heolfief/WakeupLightController/Software/Bluetooth data frame.pdf

1rst Byte | 2nd Byte
MSB | | | LSB | MSB | LSB
ID | | DAY | | DATA

# Bluetooth data frame
