heolfief/WakeupLightController/Hardware/Schematics.pdf

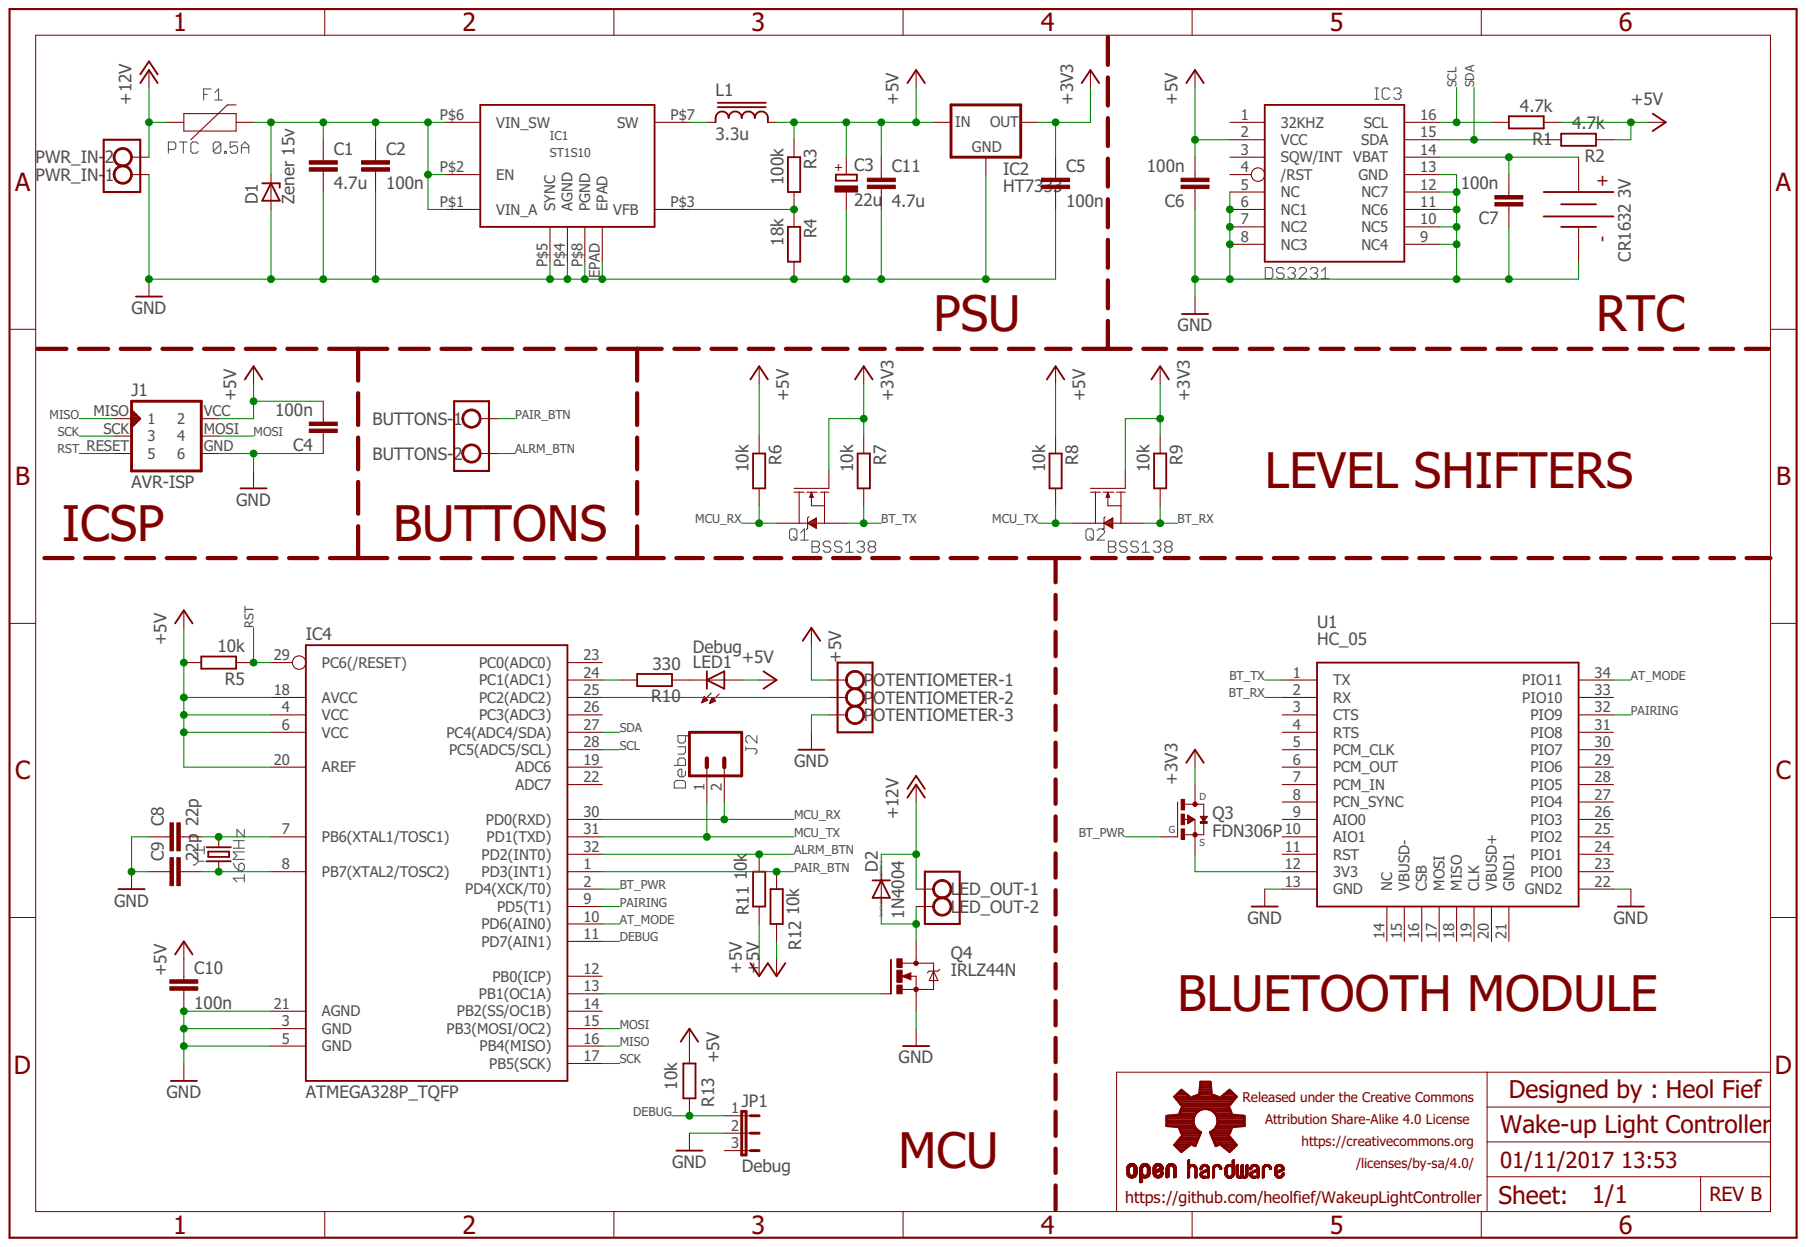
[picture p1: page 1]

Attribution Share-Alike 4.0 License https://creativecommons.org

https://github.com/heolfief/WakeupLightController
