heolfief/WakeupLightController/Software/States flowchart.pdf

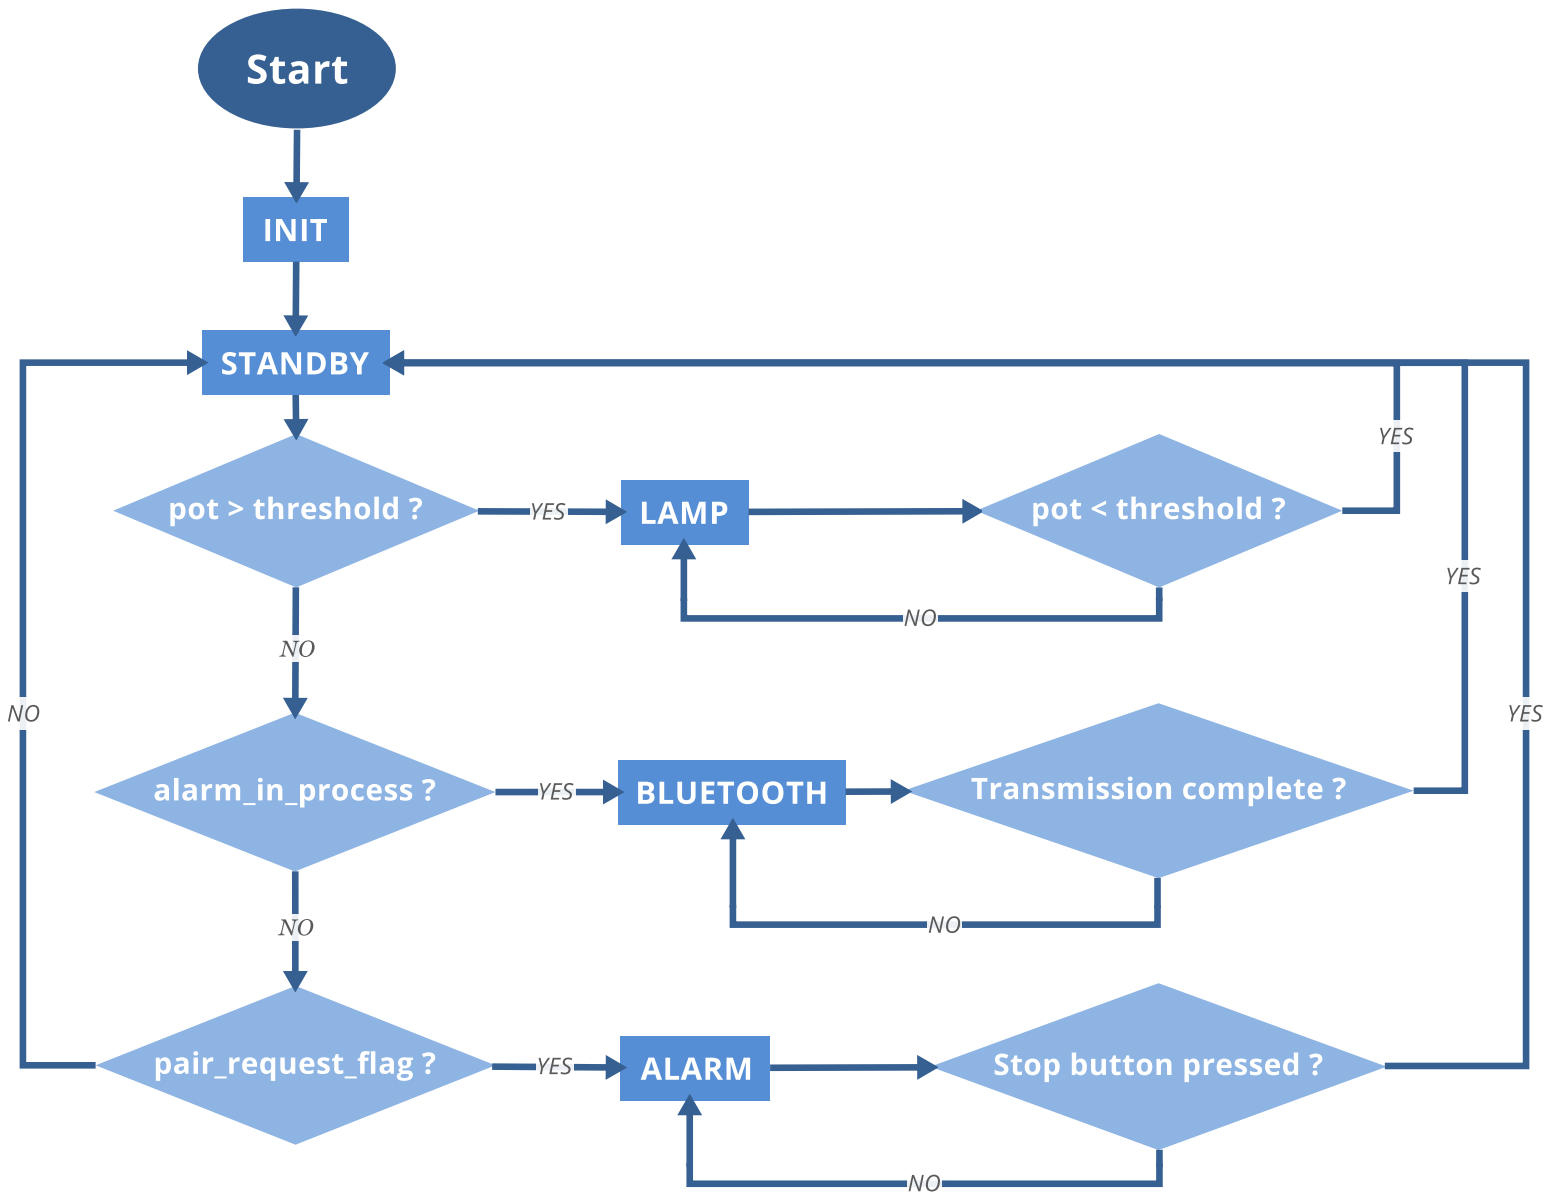
[picture p2: page 1]
