heolfief/WakeupLightController/Hardware/Wake-up Light Controller.brd

## EAGLE design Hardware/Wake-up Light Controller.brd (2017-11-01)

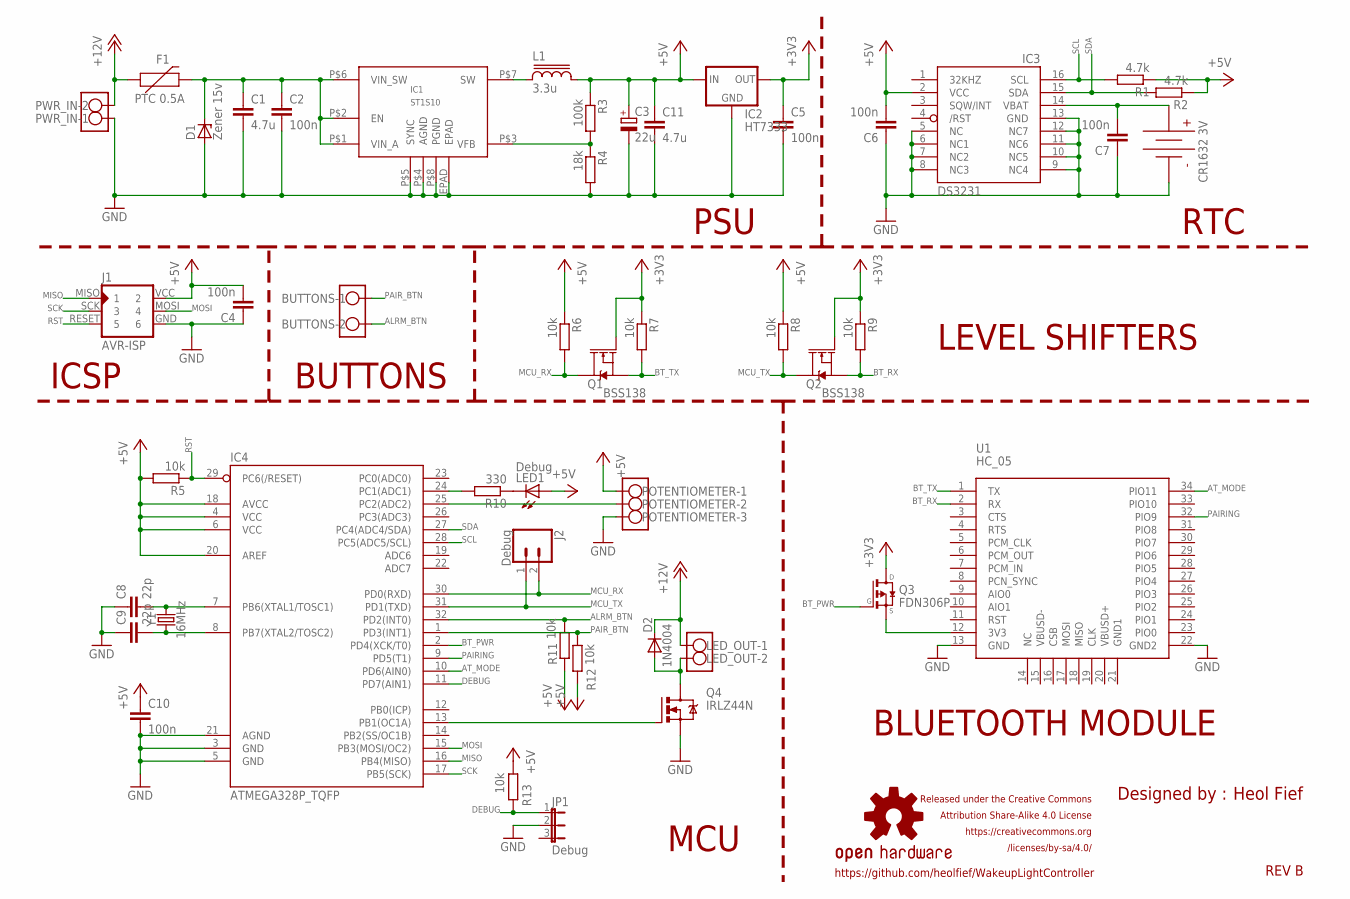
[picture p3: schematic Wake-up Light Controller.sch]

Parts:
BUTTONS: W237-102
C1, C11: 4.7u; C0805
C2, C4, C5, C6, C7, C10: 100n; C0805
C3: 22u; 153CLV-0405
C8, C9: 22p; C0805
D1: Zener 15v; SOD80C
D2: 1N4004; DO-214AC
F1: PTC 0.5A; PTH
IC1: ST1S10
IC2: HT7333; SOT-89
IC3: DS3231/SO; SO16W
IC4: ATMEGA328P_TQFP; TQFP32-08
J1: AVR-ISP; AVR-ISP-6PIN-SMAILL-SILK
J2: Debug; 1X02_NO_SILK
J3: CR1632_3V; BATTCON_16MM_PTH
JP1: Debug; JP2
L1: 3.3u; 74437346068
LED1: Debug; CHIPLED_1206
LED_OUT: W237-102
LOGO1: OSHW-LOGOM-COPPER; OSHW-LOGO-M_COPPER
POTENTIOMETER: W237-103
PWR_IN: W237-102
Q1, Q2: BSS138; SOT23-3
Q3: FDN306P; SSOT-3
Q4: IRLZ44N; TO220BH
R1, R2: 4.7k; M0805
R3: 100k; M0805
R4: 18k; M0805
R5, R6, R7, R8, R9, R11, R12, R13: 10k; M0805
R10: 330; M0805
U1: HC_05; BLUETOOTH_SMD
Y1: 16MHz; CRYSTAL-SMD-3.2X2.5MM

Connections:
+3V3: C5.1, IC2.1 (OUT), Q1.1 (G), Q2.1 (G), Q3.3 (D), R7.1, R9.1
+5V: C3.+, C4.2, C6.2, C10.1, C11.1, IC2.3 (IN), IC2.4 (IN), IC3.2 (VCC), IC4.4 (VCC), IC4.6 (VCC), IC4.18 (AVCC), IC4.20 (AREF), J1.VCC (2), L1.2, LED1.A, POTENTIOMETER.1, R1.1, R2.1, R3.1, R5.2, R6.1, R8.1, R11.1, R12.1, R13.2
+12V: D2.C, F1.P$1 (1), LED_OUT.1, PWR_IN.2
ALRM_BTN: BUTTONS.2, IC4.32 (PD2(INT0)), R11.2
AT_MODE: IC4.10 (PD6(AIN0)), U1.34 (PIO11)
BT_PWR: IC4.2 (PD4(XCK/T0)), Q3.1 (G)
BT_RX: Q2.2 (S), R9.2, U1.2 (RX)
BT_TX: Q1.2 (S), R7.2, U1.1 (TX)
DEBUG: IC4.11 (PD7(AIN1)), JP1.1, R13.1
GND: C1.2, C2.2, C3.-, C4.1, C5.2, C6.1, C7.1, C8.1, C9.1, C10.2, C11.2, D1.A, IC1.EPAD, IC1.P$4 (AGND), IC1.P$5 (SYNC), IC1.P$8 (PGND), IC2.2 (GND), IC3.5 (NC), IC3.6 (NC1), IC3.7 (NC2), IC3.8 (NC3), IC3.9 (NC4), IC3.10 (NC5), IC3.11 (NC6), IC3.12 (NC7), IC3.13 (GND), IC4.3 (GND), IC4.5 (GND), IC4.21 (AGND), J1.GND (6), J3.GND, JP1.2, POTENTIOMETER.3, PWR_IN.1, Q4.S, R4.2, U1.13 (GND), U1.22 (GND2)
MCU_RX: IC4.30 (PD0(RXD)), J2.2, Q1.3 (D), R6.2
MCU_TX: IC4.31 (PD1(TXD)), J2.1, Q2.3 (D), R8.2
MISO: IC4.16 (PB4(MISO)), J1.MISO (1)
MOSI: IC4.15 (PB3(MOSI/OC2)), J1.MOSI (4)
unnamed: D2.A, LED_OUT.2, Q4.D
unnamed: C8.2, IC4.7 (PB6(XTAL1/TOSC1)), Y1.3 (2)
unnamed: IC4.24 (PC1(ADC1)), R10.2
unnamed: C9.2, IC4.8 (PB7(XTAL2/TOSC2)), Y1.1
unnamed: Q3.2 (S), U1.12 (3V3)
unnamed: IC1.P$7 (SW), L1.1
unnamed: IC1.P$3 (VFB), R3.2, R4.1
unnamed: LED1.C, R10.1
unnamed: C1.1, C2.1, D1.C, F1.P$2 (2), IC1.P$1 (VIN_A), IC1.P$2 (EN), IC1.P$6 (VIN_SW)
unnamed: IC4.13 (PB1(OC1A)), Q4.G
unnamed: IC4.25 (PC2(ADC2)), POTENTIOMETER.2
PAIRING: IC4.9 (PD5(T1)), U1.32 (PIO9)
PAIR_BTN: BUTTONS.1, IC4.1 (PD3(INT1)), R12.2
RST: IC4.29 (PC6(/RESET)), J1.RESET (5), R5.1
SCK: IC4.17 (PB5(SCK)), J1.SCK (3)
SCL: IC3.16 (SCL), IC4.28 (PC5(ADC5/SCL)), R1.2
SDA: IC3.15 (SDA), IC4.27 (PC4(ADC4/SDA)), R2.2
VBAT: C7.2, IC3.14 (VBAT), J3.VCC@1 (VCC), J3.VCC@2 (VCC)

Notes on the sheet:
PSU
ICSP
MCU
REV B
Heol Fief
Designed by :
Released under the Creative Commons Attribution Share-Alike 4.0 License https://creativecommons.org /licenses/by-sa/4.0/
BLUETOOTH MODULE
RTC
BUTTONS
LEVEL SHIFTERS
CR1632 3V
https://github.com/heolfief/WakeupLightController

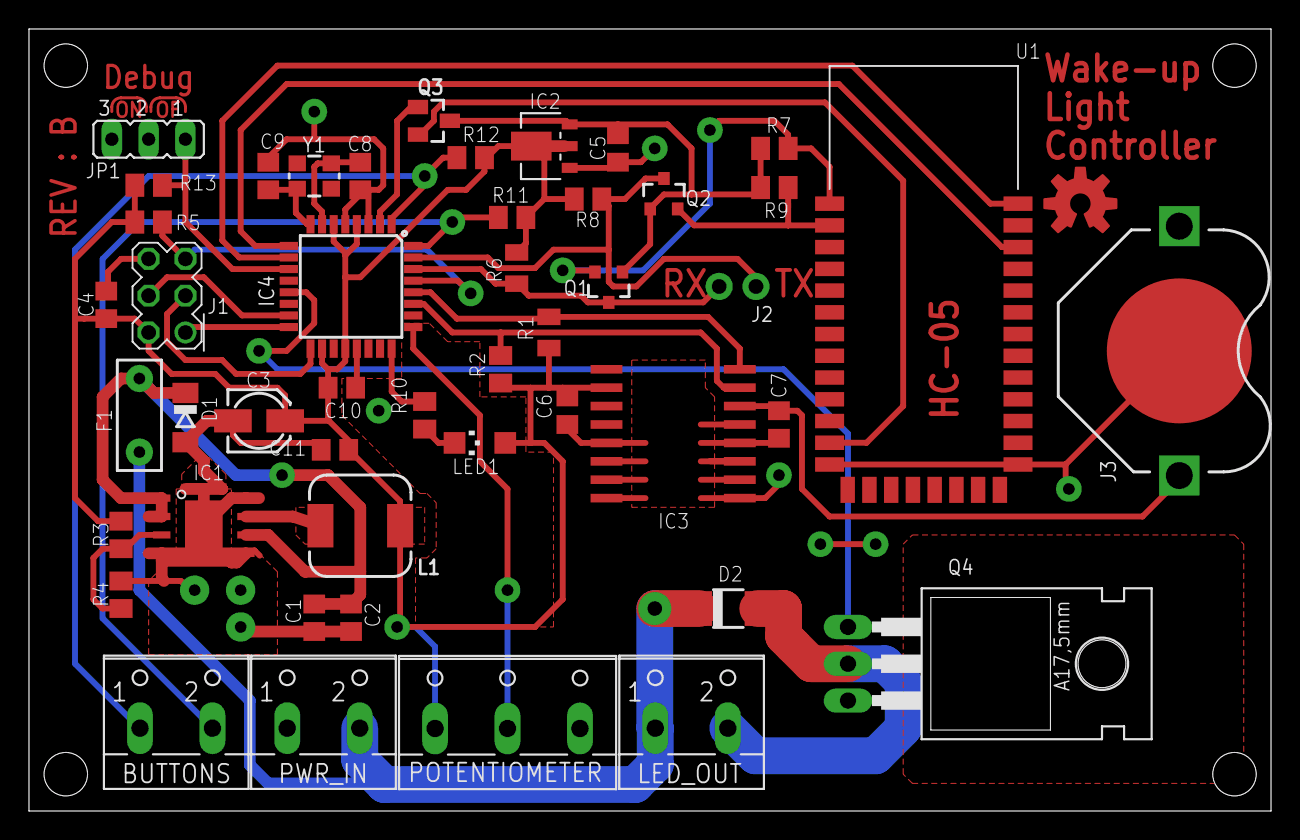
[picture p4: board Wake-up Light Controller.brd from above]

Board: 2 copper layers, 85.7 x 54.0 mm, 48 parts (0 on the bottom side), 32 nets.
