heolfief/WakeupLightController/(commit log)

2017-08-30 Add hardware Eagle files
    [Wake-up Light Controller.brd, Wake-up Light Controller.sch]
2017-09-01 Place silkscreen
    Place silkscreen, and change i2c pullups to 4.7k ohm
    [Wake-up Light Controller.brd, Wake-up Light Controller.sch]
2017-09-01 Reshaped one trace
    [Wake-up Light Controller.brd]
2017-09-02 Mention I2C lib credentials
2017-09-04 Add schematics pdf
2017-09-04 Add 3D board render for readme.md
2017-09-04 Bold pin names
2017-09-05 Group ISRs and remove reset loop of OCR1A
    [main.c]
2017-09-07 Add states flowchart
2017-09-10 Removed soft-powered RTC
    RTC is now hard-powered (directly powered on PCB)
2017-09-10 REV B
    Add debug function,
    Add RTC battery,
    Changed global layout
    [Wake-up Light Controller.brd, Wake-up Light Controller.sch]
2017-09-14 Add PTC fuse on 12V input
    [Wake-up Light Controller.brd, Wake-up Light Controller.sch]
2017-09-14 Modify copper trace
    [Wake-up Light Controller.brd]
2017-09-17 Add overvoltage protection
    [Wake-up Light Controller.brd, Wake-up Light Controller.sch]
2017-09-17 Change diodes names
    [Wake-up Light Controller.brd, Wake-up Light Controller.sch]
2017-09-17 Changed resistor pad spacing
    [Wake-up Light Controller.brd, Wake-up Light Controller.sch]
2017-09-17 Move via
    [Wake-up Light Controller.brd]
2017-09-17 Changed battery holder name
    [Wake-up Light Controller.brd, Wake-up Light Controller.sch]
2017-09-21 Changed inductor package
    [Wake-up Light Controller.brd, Wake-up Light Controller.sch]
2017-10-01 Modify copper traces
    [Wake-up Light Controller.brd]
2017-10-08 Add bluetooth data serial frame
2017-10-17 Isolate ADC trace from switching PSU
    [Wake-up Light Controller.brd, Wake-up Light Controller.sch]
2017-10-18 Optimize layout
    [Wake-up Light Controller.brd, Wake-up Light Controller.sch]
2017-10-22 Change text size
    [Wake-up Light Controller.brd]
2017-10-31 Add filtering cap, tweak layout
    [Wake-up Light Controller.brd, Wake-up Light Controller.sch]
2017-11-01 Changed component value
    Add "debug" value to jumper JP1
    [Wake-up Light Controller.brd, Wake-up Light Controller.sch]
